WangBaren02/Image-acquisition-and-recognition-robotic-arm-analysis-and-control-system-based-on-FPGA/rtl/vision/color_space/reference/README.md

# 颜色空间参考实现

[`VIP_RGB888_YCbCr444.v`](VIP_RGB888_YCbCr444.v) 是新上传目录中的独立颜色空间参考模块。文件内保留 CrazyBingo Corporation 的版权、作者和授权说明。

当前图像端顶层使用的是 [`../rgb2ycbcr.v`](../rgb2ycbcr.v)，不是本目录的 `VIP_RGB888_YCbCr444`。本目录文件不应被描述为活动实现或个人原创代码。
