WangBaren02/Image-acquisition-and-recognition-robotic-arm-analysis-and-control-system-based-on-FPGA/docs/competition_presentation.pdf

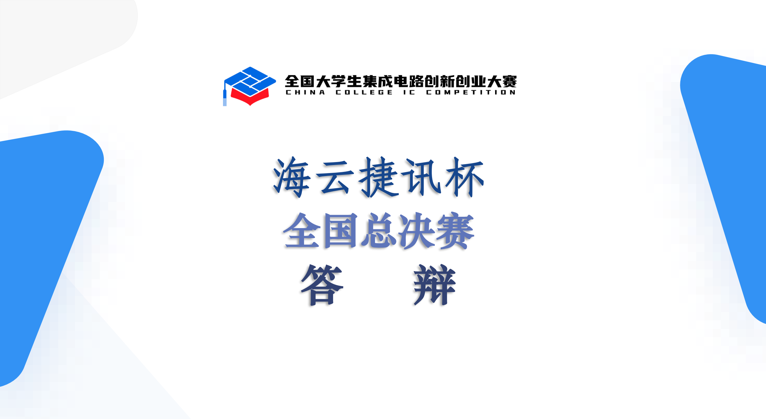
[picture p52: page 1]

# 海云捷讯杯

# 全国总决赛

答 辩

# 基于FPGA的图像识别和机械臂精准控制系统设计

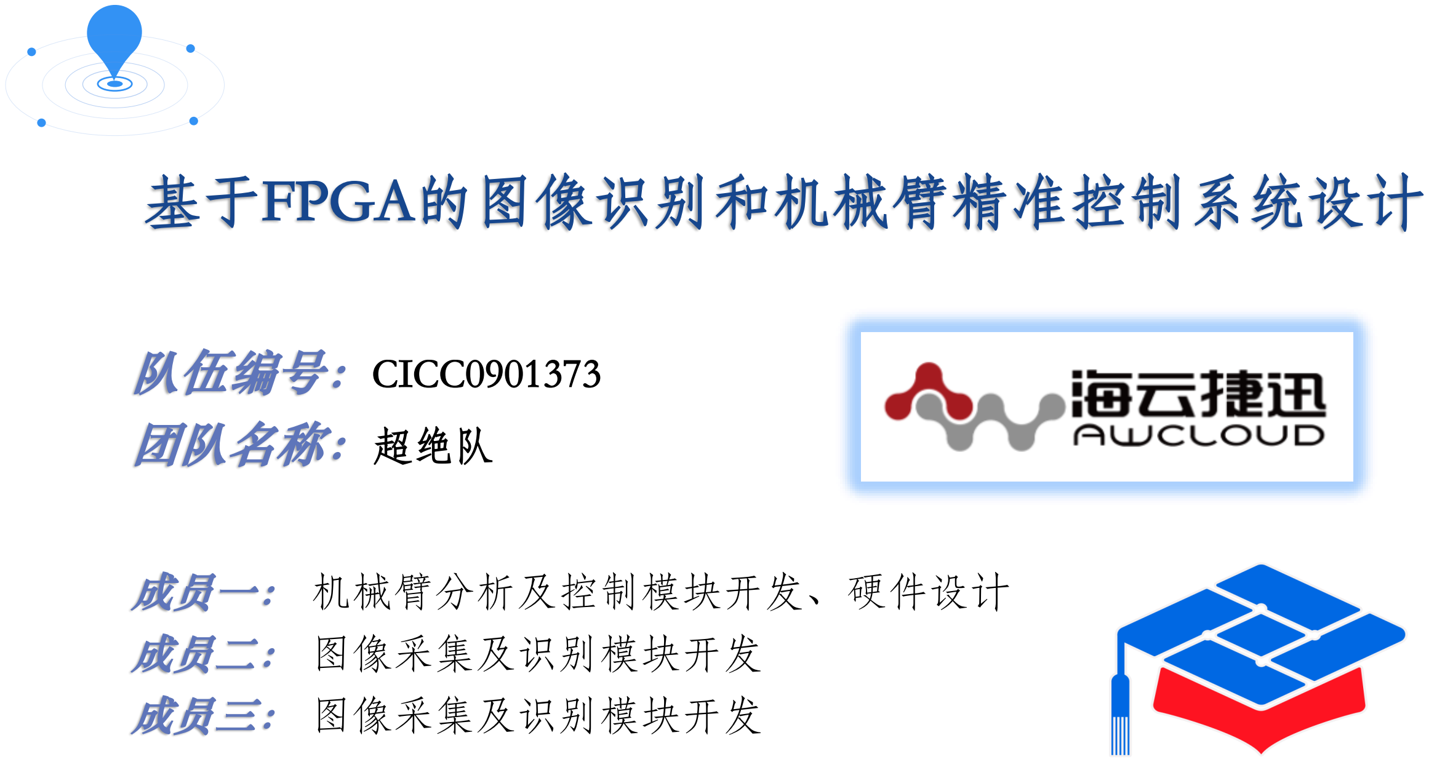
[picture p53: page 2]

## 队伍编号：CICC0901373

## 团队名称：超绝队

## 成员一： 机械臂分析及控制模块开发、硬件设计 成员二： 图像采集及识别模块开发 成员三： 图像采集及识别模块开发

目 录

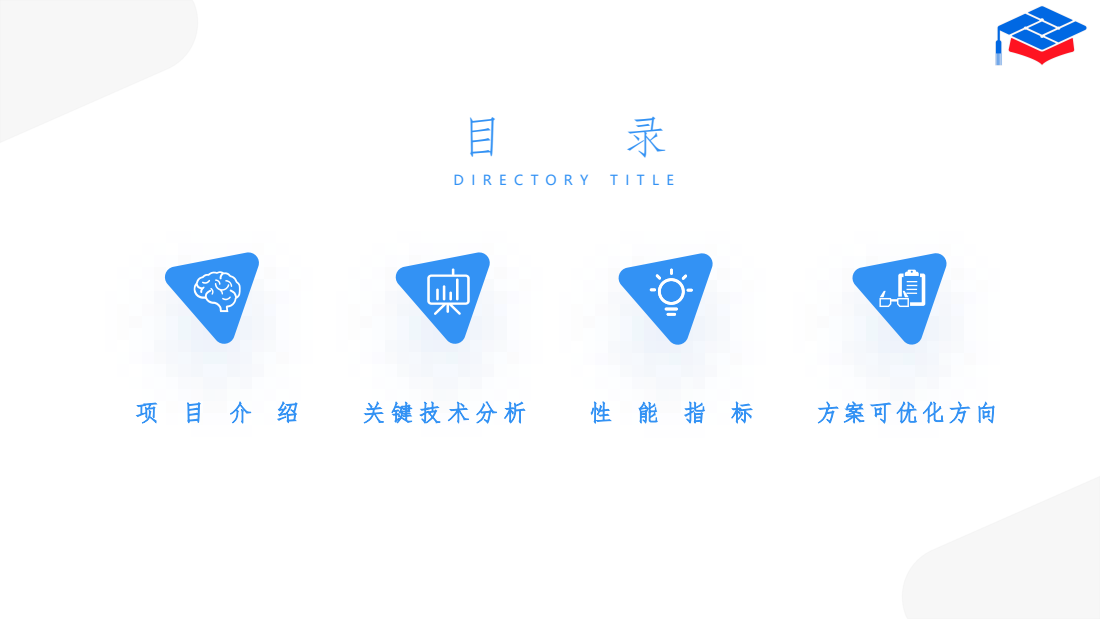
[picture p54: page 3]
项目介绍; 性能指标; 方案可优化方向

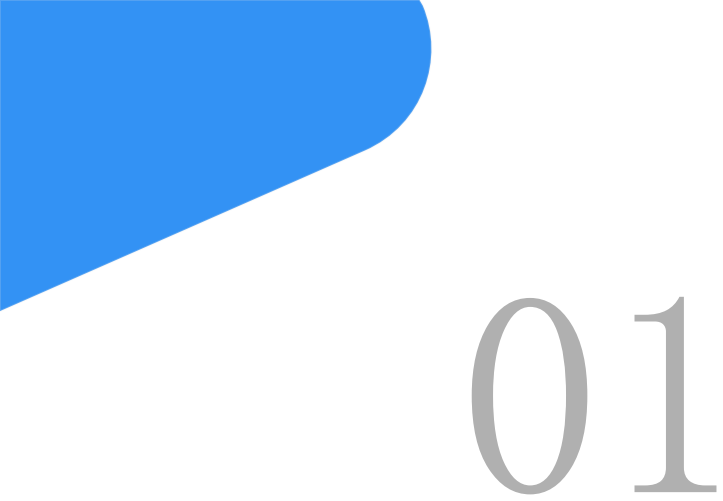
[picture p55: figure]

# 项目介绍

# 系统总体设计方案

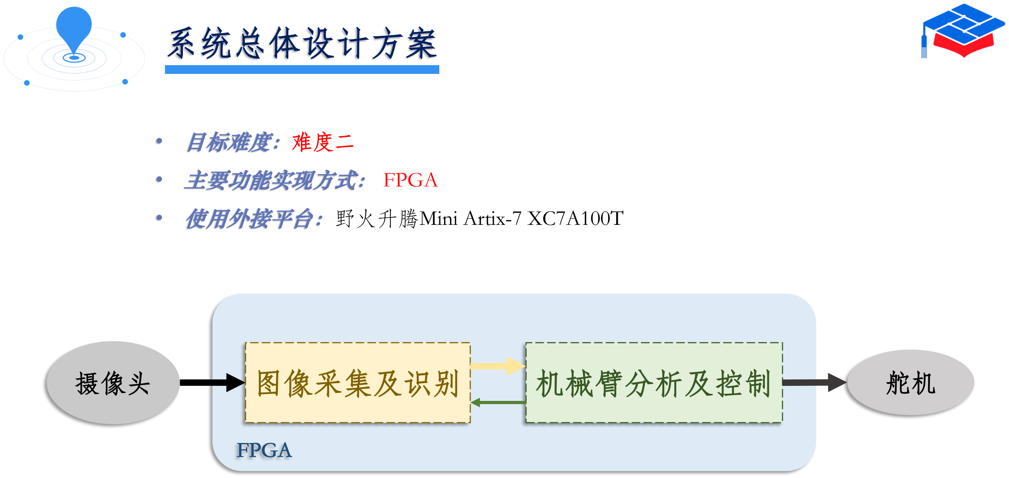
[picture p56: page 5]

- 目标难度：难度二
- 主要功能实现方式： FPGA
- 使用外接平台：野火升腾Mini Artix-7 XC7A100T
摄像头 | 图像采集及识别 | 机械臂分析及控制 | 舵机
| FPGA

## FPGA

# 总系统结构流程图

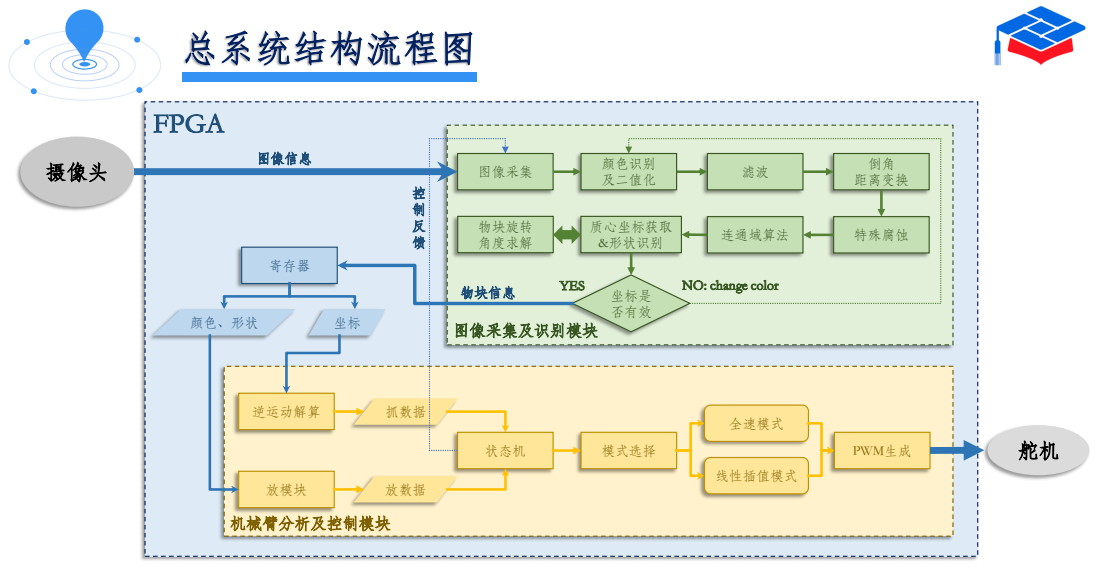
[picture p57: page 6]
逆运动解算; 抓数据; 全速模式; 放模块; 机械臂分析及控制模块; 放数据; 状态机; 模式选择; 线性插值模式; PWM生成; 图像采集; 颜色识别; 及二值化; 距离变换; 连通域算法; 特殊腐蚀 物块旋转; 角度求解; 寄存器; 图像采集及识别模块; 摄像头; 坐标是 否有效; 质心坐标获取 &形状识别; 图像信息; 物块信息; YES; NO: change color

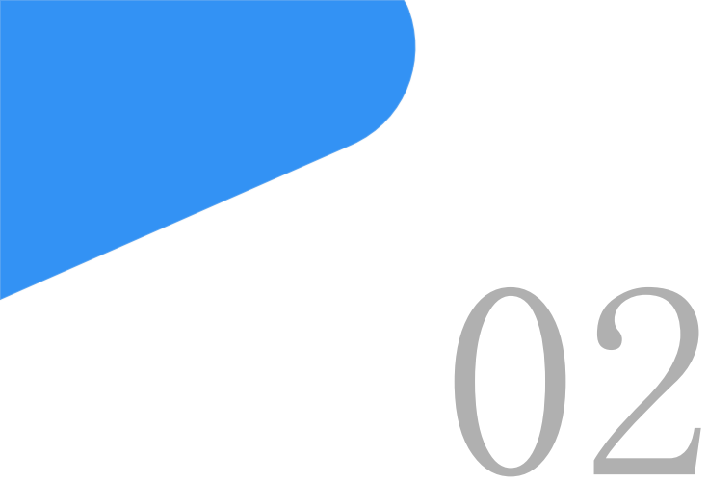
[picture p58: figure]
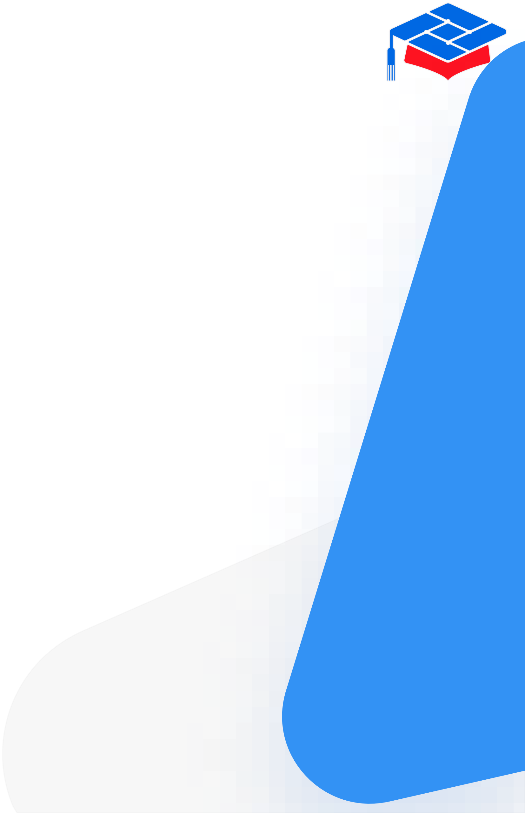
[picture p59: figure]

# 关键技术分析

# 图像采集及识别

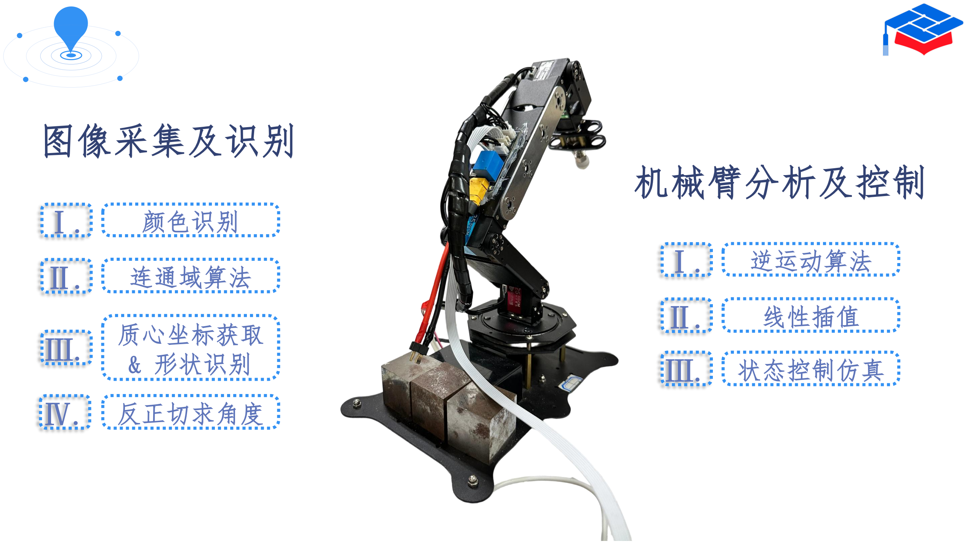
[picture p60: page 8]

## 连通域算法

## 颜色识别

Ⅱ.

Ⅰ.

# 机械臂分析及控制

## 质心坐标获取

Ⅲ & 形状识别 .

## 线性插值

## 逆运动算法

Ⅱ.

Ⅰ.

## Ⅲ. 状态控制仿真

Ⅳ

## . 反正切求角度

# 2.1 图像采集及识别模块流程

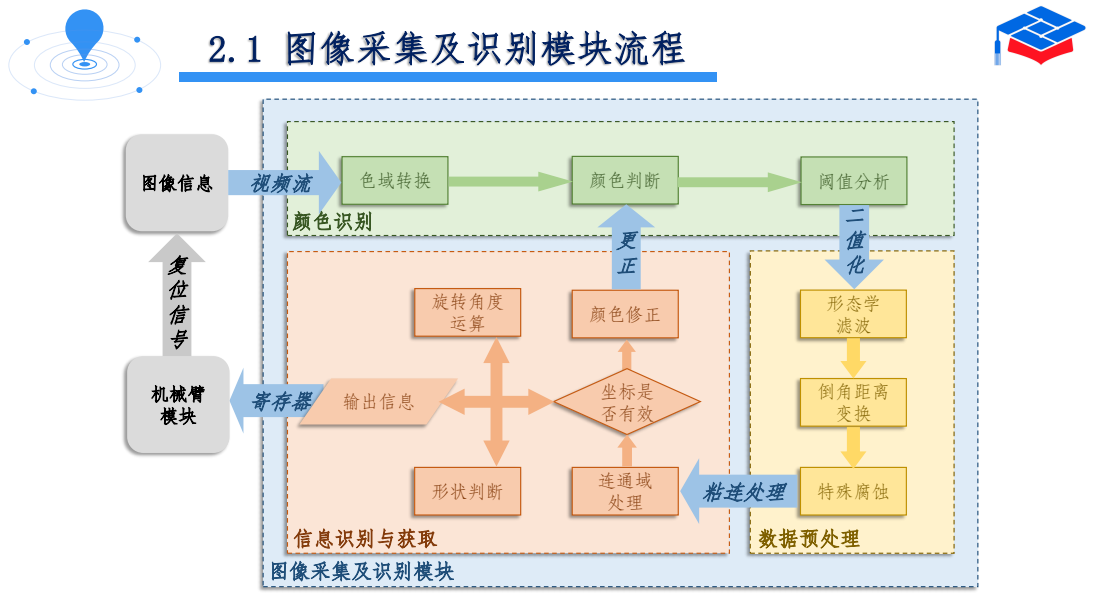
[picture p61: page 9]
图像信息; 色域转换; 颜色判断; 阈值分析; 形态学 滤波; 倒角距离 变换; 特殊腐蚀; 颜色修正; 连通域 处理; 坐标是 否有效; 旋转角度 运算; 形状判断; 机械臂; 寄存器; 输出信息 模块; 粘连处理; 视频流; 图像采集及识别模块; 颜色识别; 信息识别与获取; 数据预处理

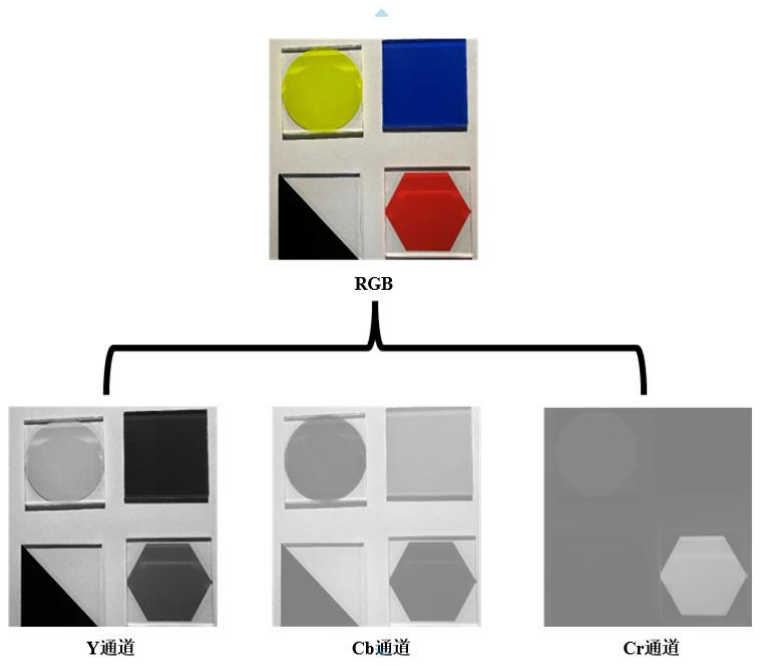
[picture p62: figure]

颜色 | 特征 | 控制阈值
红 | Y分量比黑色大且Cr分量最大 | Y、Cr

黄

Y分量在四种颜色里最大
且Cb分量最小 | Y、Cb

蓝

Y分量比黑色大、比红色小
且Cb分量最大 | Y、Cb
黑 | Y分量最小 | Y

采用两遍扫描法，在一帧图像的前一行打上标签，第二行进行上一行标签的更新。

给互不相连的物体打上不同的标签，以此达成分离物体的目的。

使用八连通域:指定像素的上下左右以及对角线方向上的8个像素为相邻像素。

在实现过程中对某一像素做具体判断的时候，只需要考虑头上三个以及左边的像素即可。

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
更新前标签 | 更新后标签

（a）

P

(x-1,y-1) | (x+1,y-1)

(x-1,y)
(b)

P

(x-1,y)

(x,y-1)

A.

B.

## 仿真结果（640 X 480）：

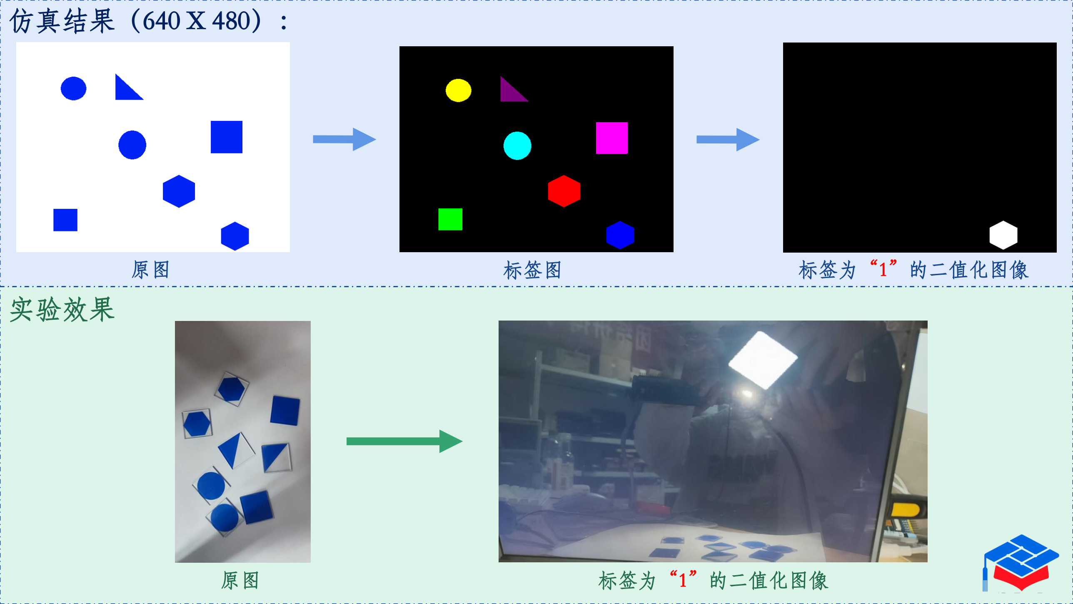
[picture p63: page 12]

原图 | 标签图 | 标签为“1”的二值化图像
原图 | 标签为“1”的二值化图像

## 实验效果

## A.加权平均值求质心

公式：

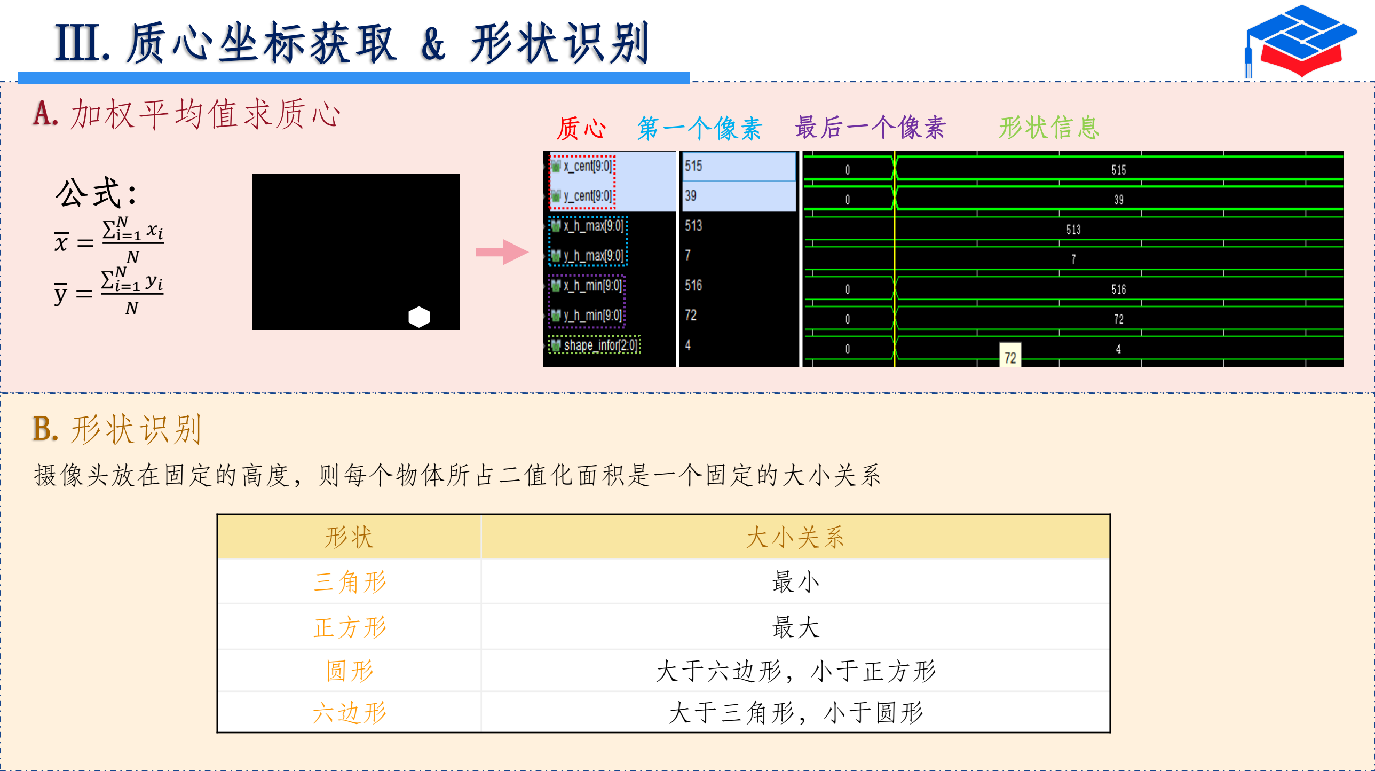
[picture p64: page 13]

形状 | 大小关系
三角形 | 最小
正方形 | 最大
圆形 | 大于六边形，小于正方形
六边形 | 大于三角形，小于圆形

x =

σi=1

N xi

N
y =

σi=1

N yi

N

# Ⅲ.质心坐标获取 & 形状识别

摄像头放在固定的高度，则每个物体所占二值化面积是一个固定的大小关系

## B.形状识别

质心 第一个像素 最后一个像素 形状信息

# Ⅳ.反正切求角度

圆形

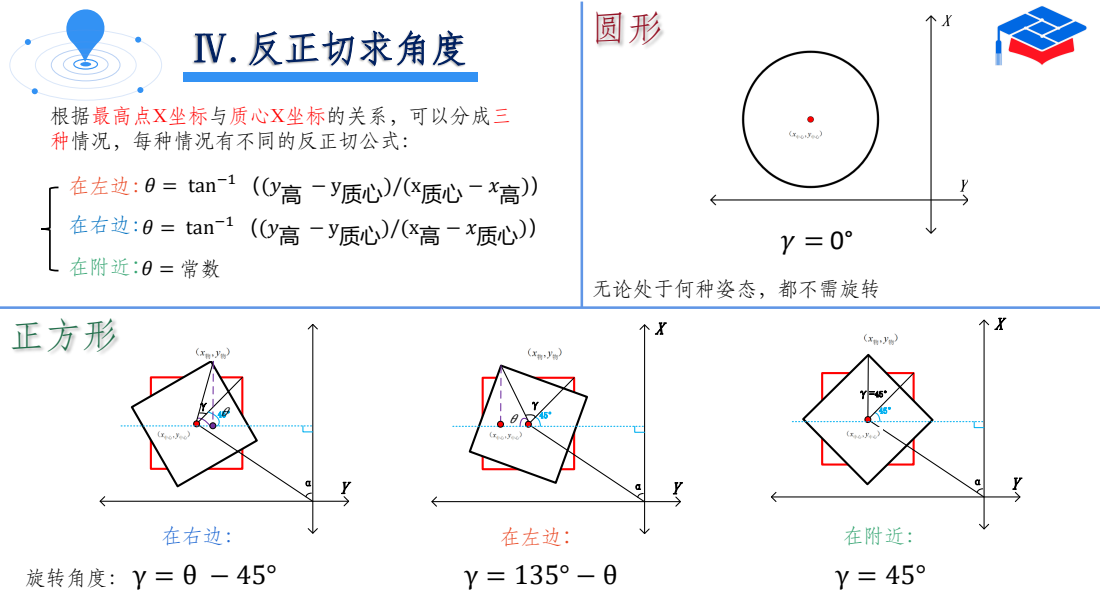
[picture p65: page 14]
根据最高点X坐标与质心X坐标的关系，可以分成三 种情况，每种情况有不同的反正切公式：; 在左边：; 在右边：; 在附近： θ = 常数; 无论处于何种姿态，都不需旋转; 正方形; 在附近：; 旋转角度： γ = θ − 45°

θ = tan⁻¹ （(y高 − y质心)/(x质心 − x高)）

θ = tan⁻¹ （(y高 − y质心)/(x高 − x质心)）

# 六边形 三角形

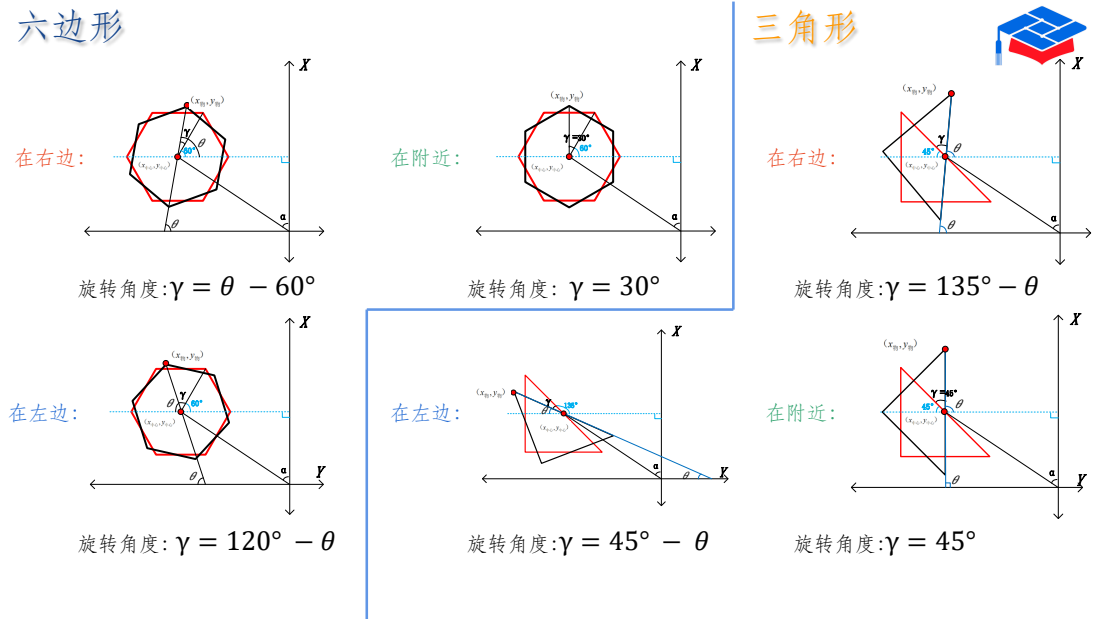
[picture p66: page 15]
旋转角度：γ = θ − 60°; 旋转角度：γ = 120° − θ; 在右边：; 在左边：; 在附近：; 旋转角度：γ = 30°; 旋转角度：γ = 135° − θ; 旋转角度：γ = 45° − θ; 旋转角度：γ = 45°

# 2.2 机械臂分析及控制模块流程

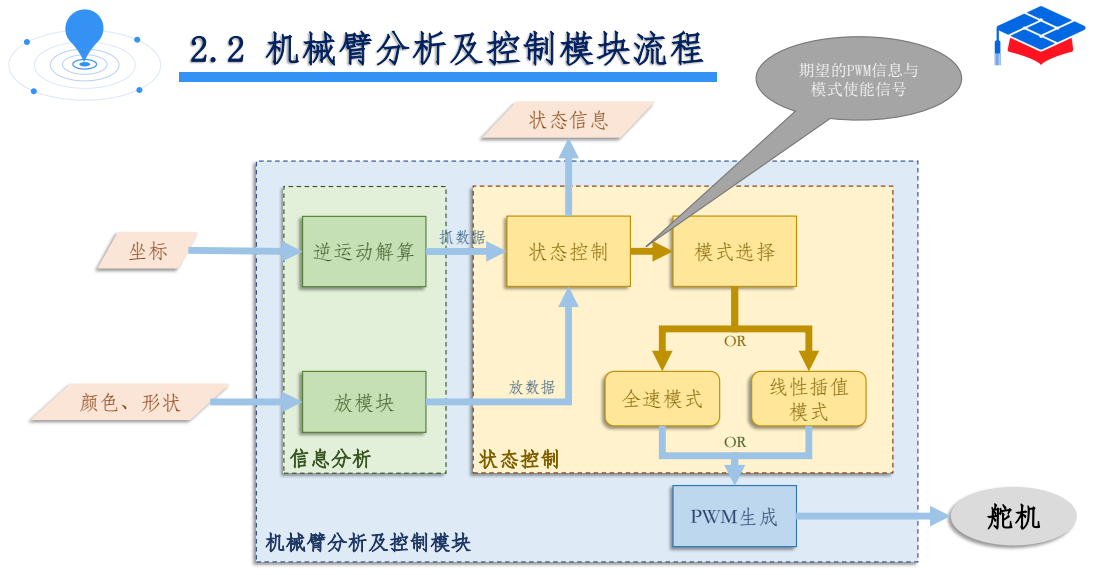
[picture p67: page 16]
逆运动解算; 模式选择; 全速模式; 线性插值 颜色、形状; 放模块; 状态控制; PWM生成; 信息分析; 期望的PWM信息与 模式使能信号; 抓数据; 放数据; 机械臂分析及控制模块; 状态信息

# Ⅰ.逆运动算法

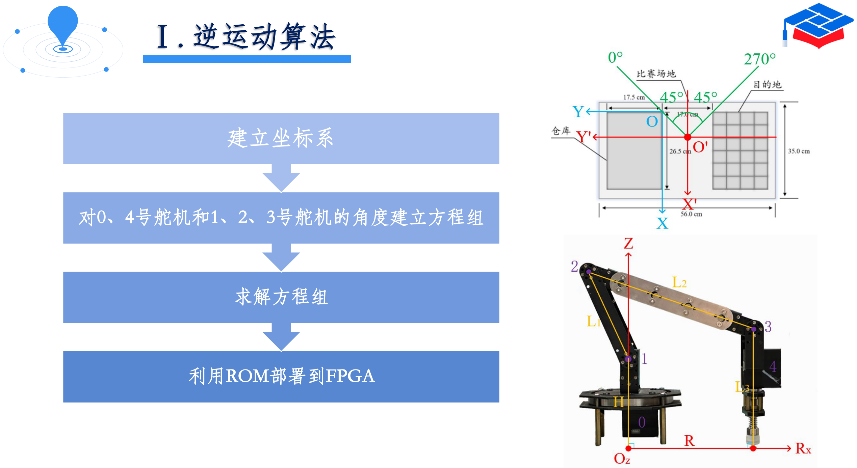
[picture p68: page 17]

利用ROM部署到FPGA

求解方程组

对0、4号舵机和1、2、3号舵机的角度建立方程组

## 建立坐标系

0、4号舵机角度的求解 | 1号、2号、3号舵机角度的求解

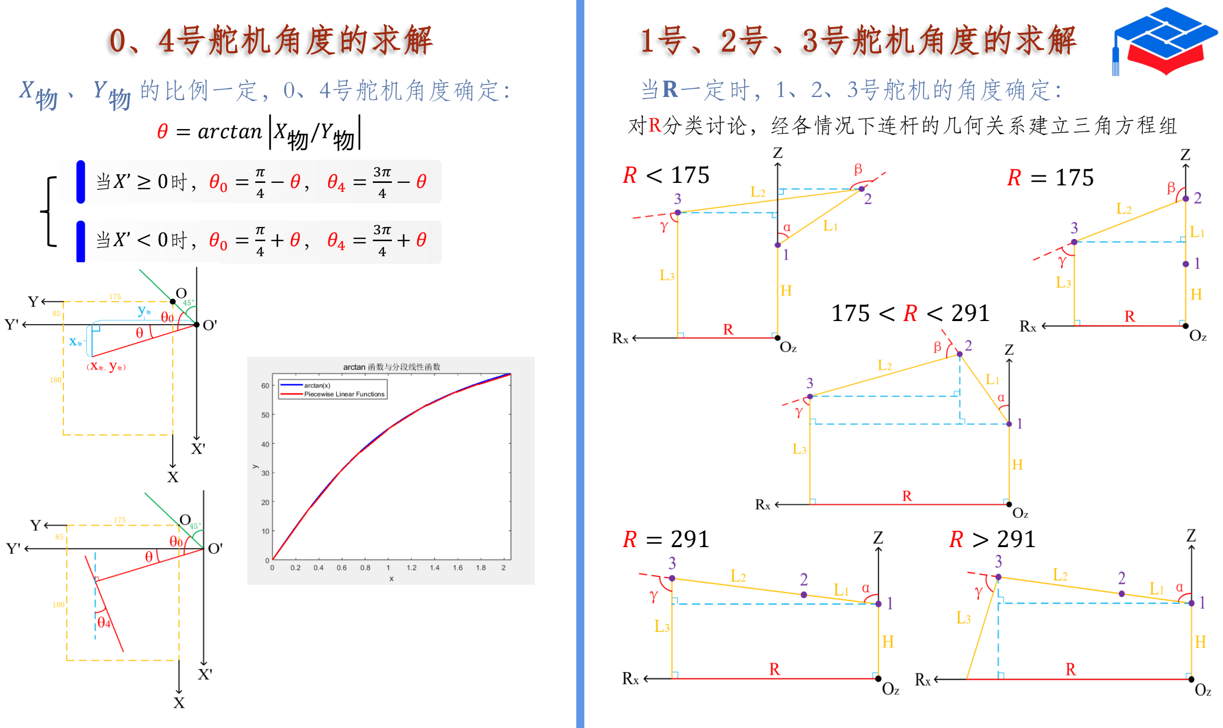
[picture p69: page 18]

当R一定时，1、2、3号舵机的角度确定：
对R分类讨论，经各情况下连杆的几何关系建立三角方程组

当X’ ≥ 0时，θ0 =

π
4

− θ， θ4 =

3π
4

− θ

X物 、 Y物 的比例一定，0、4号舵机角度确定：

θ = arctan X物/Y物

当X’ < 0时，θ0 =

π
4

+ θ， θ4 =

3π
4

+ θ

R < 175 | R = 175

175 < R < 291

R = 291 | R > 291

# Ⅱ.线性插值

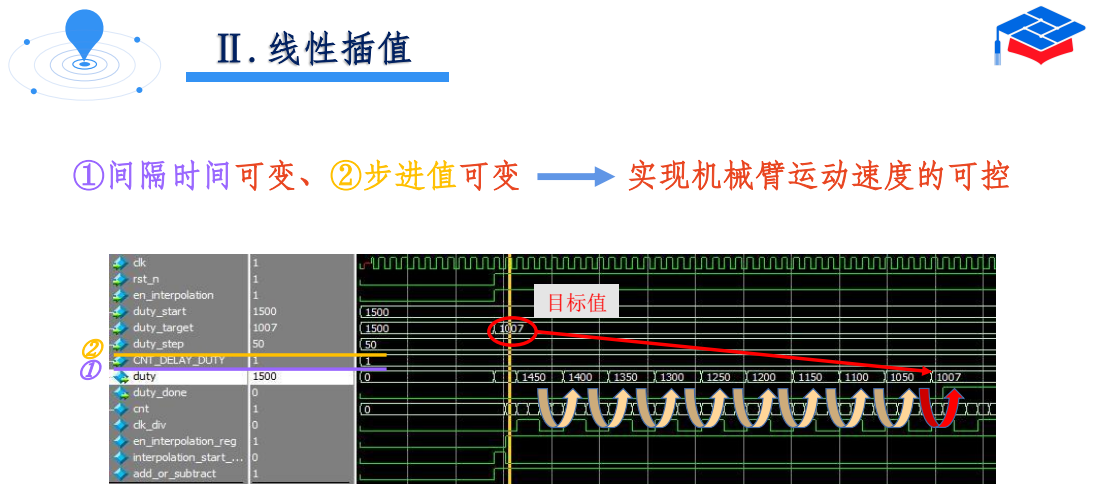
[picture p70: page 19]
①间隔时间可变、②步进值可变; 实现机械臂运动速度的可控; 目标值

抓姿态 | 复位姿态 | 放姿态

# Ⅲ.状态控制

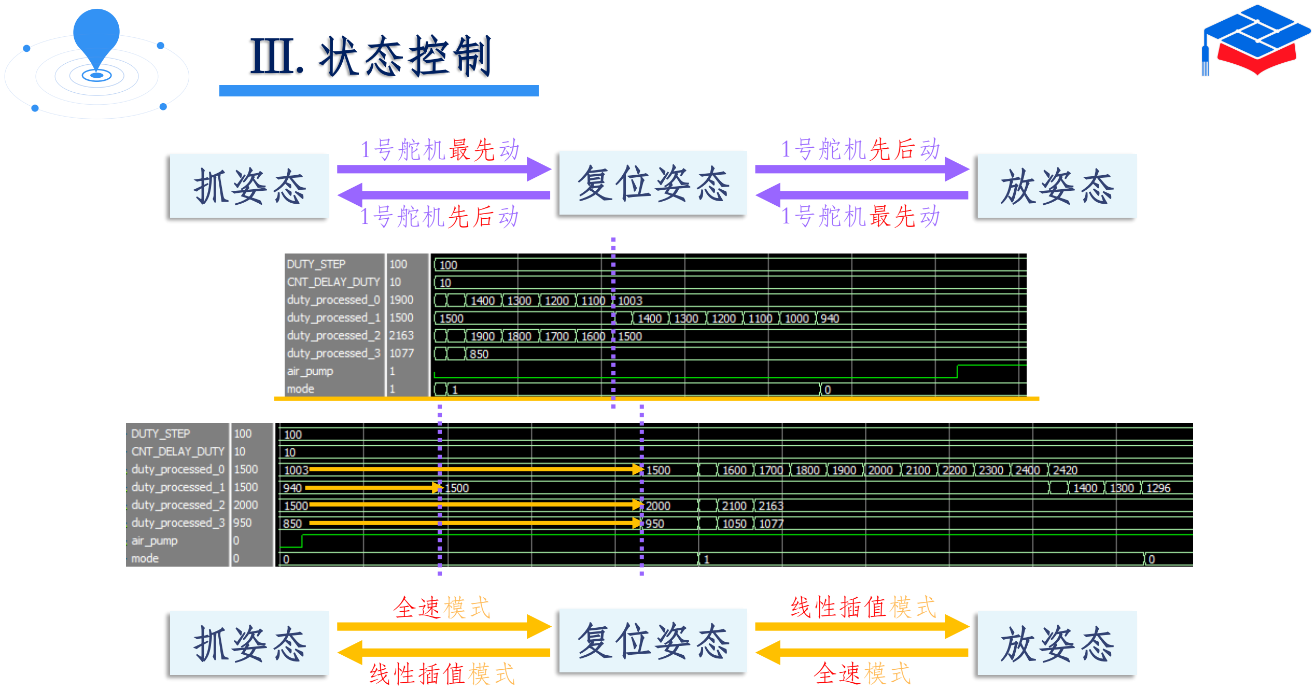
[picture p71: page 20]

1号舵机最先动

1号舵机先后动 | 1号舵机最先动 1号舵机先后动
抓姿态 | 复位姿态 | 放姿态

全速模式

线性插值模式 | 全速模式

线性插值模式

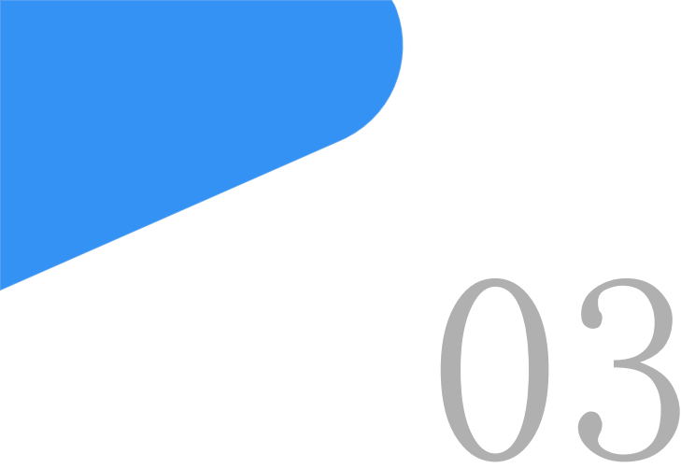
[picture p72: figure]

# 性能分析

测试序号 | 总时间(s) | 均方根误差(cm) | 方差(cm2
) | 均值误差(cm)
① | 6.94N | 1.45 | 2.27 | 1.30
② | 5.27N | 2.11 | 4.77 | 1.92
③ | 12.96N | 0.35 | 0.13 | 0.27

# 测试表

指标 | 此系统
目标锁定时间(s) | 0.067N
完成任务总时间(s) | 6.94N
定位精度 | 一般

# 性能指标

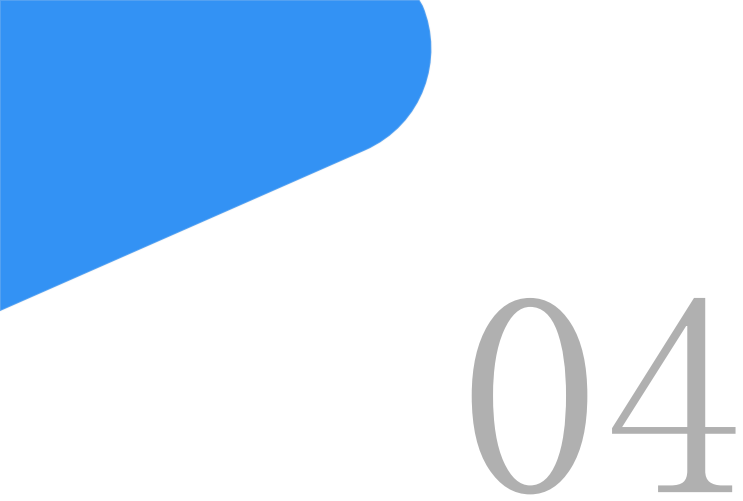
[picture p73: figure]
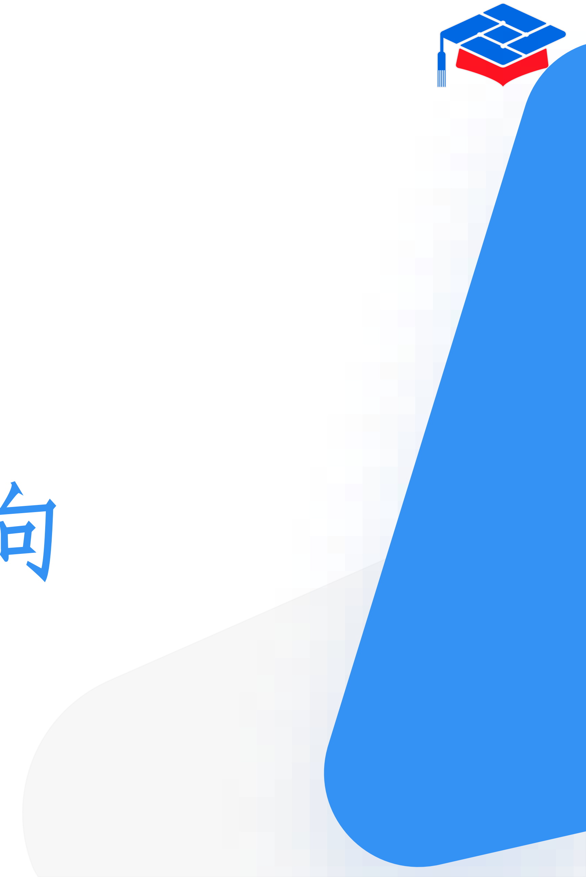
[picture p74: figure]

# 方案可优化方向

1
1
2 | 2 | 1 | 1

1
1
1 | 1 | 1 | 1

解决方案:在处理当前行标签的时候，增加“回溯”功能即增加固定次数的循环结构，把当前所要 给的标签赋值给被循环的像素。

解决方案:在连通域模块之前添加滤波/腐蚀，保证模块传入的数据没有噪点。

出现问题:在本系统现阶段的连通域算法中，所处理图像的边缘由于二值化阈值范围与光照环 境影响下，可能会出现“左L”形的情景：

A.

出现问题:由于连通域算法将标签为1的物体输出，而且求取质心的公式与像素的xy坐标有关系。 所以图像识别模块容易收到噪点以及外部环境的影响

B.

更新前标签 | 更新后标签

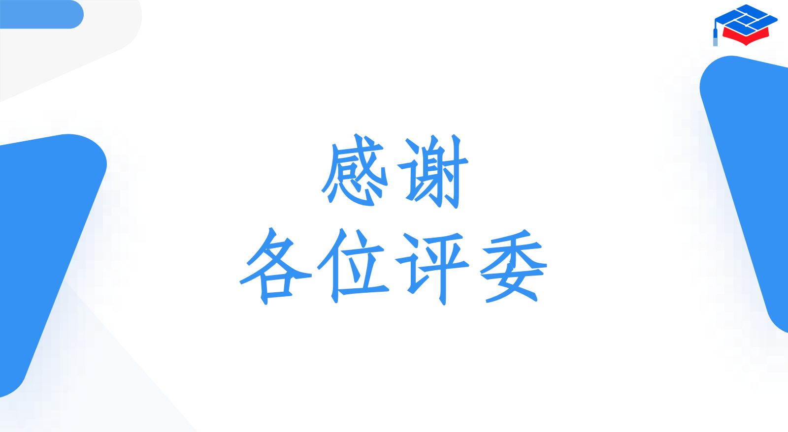
[picture p75: page 25]

感谢

# 各位评委
