WangBaren02/Image-acquisition-and-recognition-robotic-arm-analysis-and-control-system-based-on-FPGA/(list of files, drawings)

Other design files:
hardware/25集创赛海云捷讯杯.epro
