WangBaren02/Image-acquisition-and-recognition-robotic-arm-analysis-and-control-system-based-on-FPGA/rtl/display/seven_segment/bcd_8421.v

`timescale  1ns/1ns
////////////////////////////////////////////////////////////////////////
// Author  : EmbedFire
// 实验平台: 野火FPGA系列开发板
// 公司    : http://www.embedfire.com
// 论坛    : http://www.firebbs.cn
// 淘宝    : https://fire-stm32.taobao.com
////////////////////////////////////////////////////////////////////////

module  bcd_8421
(
    input   wire            sys_clk     ,   //系统时钟，频率50MHz
    input   wire            sys_rst_n   ,   //复位信号，低电平有效
    input   wire    [19:0]  data        ,   //输入需要转换的数据

    output  reg     [3:0]   unit        ,   //个位BCD码
    output  reg     [3:0]   ten         ,   //十位BCD码
    output  reg     [3:0]   hun         ,   //百位BCD码
    output  reg     [3:0]   tho         ,   //千位BCD码
    output  reg     [3:0]   t_tho       ,   //万位BCD码
    output  reg     [3:0]   h_hun           //十万位BCD码
);

//********************************************************************//
//******************** Parameter And Internal Signal *****************//
//********************************************************************//

//reg   define
reg     [4:0]   cnt_shift   ;   //移位判断计数器
reg     [43:0]  data_shift  ;   //移位判断数据寄存器
reg             shift_flag  ;   //移位判断标志信号

//********************************************************************//
//***************************** Main Code ****************************//
//********************************************************************//

//cnt_shift:从0到21循环计数
always@(posedge sys_clk or negedge sys_rst_n)
    if(sys_rst_n == 1'b0)
        cnt_shift   <=  5'd0;
    else    if((cnt_shift == 5'd21) && (shift_flag == 1'b1))
        cnt_shift   <=  5'd0;
    else    if(shift_flag == 1'b1)
        cnt_shift   <=  cnt_shift + 1'b1;
    else
        cnt_shift   <=  cnt_shift;

//data_shift：计数器为0时赋初值，计数器为1~20时进行移位判断操作
always@(posedge sys_clk or negedge sys_rst_n)
    if(sys_rst_n == 1'b0)
        data_shift  <=  44'b0;
    else    if(cnt_shift == 5'd0)
        data_shift  <=  {24'b0,data};
    else    if((cnt_shift <= 20) && (shift_flag == 1'b0))
        begin
            data_shift[23:20]   <=  (data_shift[23:20] > 4) ? (data_shift[23:20] + 2'd3) : (data_shift[23:20]);
            data_shift[27:24]   <=  (data_shift[27:24] > 4) ? (data_shift[27:24] + 2'd3) : (data_shift[27:24]);
            data_shift[31:28]   <=  (data_shift[31:28] > 4) ? (data_shift[31:28] + 2'd3) : (data_shift[31:28]);
            data_shift[35:32]   <=  (data_shift[35:32] > 4) ? (data_shift[35:32] + 2'd3) : (data_shift[35:32]);
            data_shift[39:36]   <=  (data_shift[39:36] > 4) ? (data_shift[39:36] + 2'd3) : (data_shift[39:36]);
            data_shift[43:40]   <=  (data_shift[43:40] > 4) ? (data_shift[43:40] + 2'd3) : (data_shift[43:40]);
        end
    else    if((cnt_shift <= 20) && (shift_flag == 1'b1))
        data_shift  <=  data_shift << 1;
    else
        data_shift  <=  data_shift;

//shift_flag：移位判断标志信号，用于控制移位判断的先后顺序
always@(posedge sys_clk or negedge sys_rst_n)
    if(sys_rst_n == 1'b0)
        shift_flag  <=  1'b0;
    else
        shift_flag  <=  ~shift_flag;

//当计数器等于20时，移位判断操作完成，对各个位数的BCD码进行赋值
always@(posedge sys_clk or negedge sys_rst_n)
    if(sys_rst_n == 1'b0)
        begin
            unit    <=  4'b0;
            ten     <=  4'b0;
            hun     <=  4'b0;
            tho     <=  4'b0;
            t_tho   <=  4'b0;
            h_hun   <=  4'b0;
        end
    else    if(cnt_shift == 5'd21)
        begin
            unit    <=  data_shift[23:20];
            ten     <=  data_shift[27:24];
            hun     <=  data_shift[31:28];
            tho     <=  data_shift[35:32];
            t_tho   <=  data_shift[39:36];
            h_hun   <=  data_shift[43:40];
        end

endmodule
