WangBaren02/Image-acquisition-and-recognition-robotic-arm-analysis-and-control-system-based-on-FPGA/sim/vision/sim_sobel_tb.v

`timescale 1ns / 1ps

//使用BMP图片格式仿真VIP视频图像处理算法
module sim_sobel_tb( );

integer iBmpFileId;                 //输入BMP图片
integer oBmpFileId_1;               //输出BMP图片 1

integer iIndex = 0;                 //输出BMP数据索引
integer pixel_index = 0;            //输出像素数据索引

integer iCode;

integer iBmpWidth;                  //输入BMP 宽度
integer iBmpHight;                  //输入BMP 高度
integer iBmpSize;                   //输入BMP 字节数
integer iDataStartIndex;            //输入BMP 像素数据偏移量

reg [7:0] rBmpData [0:2000000];      //用于寄存输入BMP图片中的字节数据（包括54字节的文件头）
reg [7:0] Vip_BmpData_1 [0:2000000]; //用于寄存视频图像处理之后 的BMP图片 数据

reg [7:0] rBmpWord;                //输出BMP图片时用于寄存数据（以byte为单位）

reg [ 7:0] pixel_data;              //输出视频流时的像素数据

reg clk;
reg rst_n;

reg [ 7:0] vip_pixel_data_1 [0:921600];   	//640x480x3

//---------------------------------------------
initial begin
    //打开输入BMP图片s
	 iBmpFileId      = $fopen("F:\\FPGA-EP4CE10F17C8\\change\\sim\\bmp_tb_640x480\\bmp_pic_100_4l_1.bmp","rb");

    //将输入BMP图片加载到数组中
	iCode = $fread(rBmpData,iBmpFileId);

    //根据BMP图片文件头的格式，分别计算出图片的 宽度 /高度 /像素数据偏移量 /图片字节数
	iBmpWidth       = {rBmpData[21],rBmpData[20],rBmpData[19],rBmpData[18]};
	iBmpHight       = {rBmpData[25],rBmpData[24],rBmpData[23],rBmpData[22]};
	iBmpSize        = {rBmpData[ 5],rBmpData[ 4],rBmpData[ 3],rBmpData[ 2]};
	iDataStartIndex = {rBmpData[13],rBmpData[12],rBmpData[11],rBmpData[10]};

    //关闭输入BMP图片
	$fclose(iBmpFileId);

	//打开输出BMP图片
	oBmpFileId_1 = $fopen("F:\\FPGA-EP4CE10F17C8\\change\\sim\\bmp_tb_640x480\\output_file_1.bmp","wb+");

    //延迟13ms，等待第一帧VIP处理结束
    #13000000

    //加载图像处理后，BMP图片的文件头和像素数据
	for (iIndex = 0; iIndex < iBmpSize; iIndex = iIndex + 1) begin
		if(iIndex < 54)
            Vip_BmpData_1[iIndex] = rBmpData[iIndex];
        else
            Vip_BmpData_1[iIndex] = vip_pixel_data_1[iIndex-54];
	end
    //将数组中的数据写到输出BMP图片中
	for (iIndex = 0; iIndex < iBmpSize; iIndex = iIndex + 1) begin
		rBmpWord = Vip_BmpData_1[iIndex];
		$fwrite(oBmpFileId_1,"%c",rBmpWord);
	end

    //关闭输出BMP图片
	$fclose(oBmpFileId_1);

end
//initial end

//---------------------------------------------
//初始化时钟和复位信号
initial begin
    clk     = 1;
    rst_n   = 0;
    #110
    rst_n   = 1;
end

//产生50MHz时钟
always #10 clk = ~clk;

//---------------------------------------------
//在时钟驱动下，从数组中读出像素数据，用于在Modelsim中查看BMP中的数据
always@(posedge clk or negedge rst_n)begin
    if(!rst_n) begin
        pixel_data  <=  8'd0;
        pixel_index <=  0;
    end
    else begin
        pixel_data  <=  rBmpData[pixel_index];
        pixel_index <=  pixel_index+1;
    end
end

//---------------------------------------------
//产生摄像头时序

wire		cmos_vsync ;
reg			cmos_href;
wire        cmos_clken;
reg	[23:0]	cmos_data;

reg         cmos_clken_r;

reg [31:0]  cmos_index;

parameter [10:0] IMG_HDISP = 11'd640;
parameter [10:0] IMG_VDISP = 11'd480;

localparam H_SYNC = 11'd5;
localparam H_BACK = 11'd5;
localparam H_DISP = IMG_HDISP;
localparam H_FRONT = 11'd5;
localparam H_TOTAL = H_SYNC + H_BACK + H_DISP + H_FRONT;

localparam V_SYNC = 11'd1;
localparam V_BACK = 11'd0;
localparam V_DISP = IMG_VDISP;
localparam V_FRONT = 11'd1;
localparam V_TOTAL = V_SYNC + V_BACK + V_DISP + V_FRONT;

//---------------------------------------------
//模拟 OV7725/OV5640 驱动模块输出的时钟使能
always@(posedge clk or negedge rst_n) begin
	if(!rst_n)
		cmos_clken_r <= 0;
	else
        cmos_clken_r <= ~cmos_clken_r;
end

//---------------------------------------------
//水平计数器
reg	[10:0]	hcnt;
always@(posedge clk or negedge rst_n) begin
	if(!rst_n)
		hcnt <= 11'd0;
	else if(cmos_clken_r)
		hcnt <= (hcnt < H_TOTAL - 1'b1) ? hcnt + 1'b1 : 11'd0;
end

//---------------------------------------------
//竖直计数器
reg	[10:0]	vcnt;
always@(posedge clk or negedge rst_n) begin
	if(!rst_n)
		vcnt <= 11'd0;
	else if(cmos_clken_r) begin
		if(hcnt == H_TOTAL - 1'b1)
			vcnt <= (vcnt < V_TOTAL - 1'b1) ? vcnt + 1'b1 : 11'd0;
		else
			vcnt <= vcnt;
    end
end

//---------------------------------------------
//场同步
reg	cmos_vsync_r;
always@(posedge clk or negedge rst_n) begin
	if(!rst_n)
		cmos_vsync_r <= 1'b0;			//H: Vaild, L: inVaild
	else begin
		if(vcnt <= V_SYNC - 1'b1)
			cmos_vsync_r <= 1'b0; 	//H: Vaild, L: inVaild
		else
			cmos_vsync_r <= 1'b1; 	//H: Vaild, L: inVaild
    end
end
assign	cmos_vsync	= cmos_vsync_r;

//---------------------------------------------
//行有效
wire	frame_valid_ahead =  ( vcnt >= V_SYNC + V_BACK  && vcnt < V_SYNC + V_BACK + V_DISP
                            && hcnt >= H_SYNC + H_BACK  && hcnt < H_SYNC + H_BACK + H_DISP )
						? 1'b1 : 1'b0;

reg			cmos_href_r;
always@(posedge clk or negedge rst_n) begin
	if(!rst_n)
		cmos_href_r <= 0;
	else begin
		if(frame_valid_ahead)
			cmos_href_r <= 1;
		else
			cmos_href_r <= 0;
    end
end

always@(posedge clk or negedge rst_n) begin
	if(!rst_n)
		cmos_href <= 0;
	else
        cmos_href <= cmos_href_r;
end

assign cmos_clken = cmos_href & cmos_clken_r;

//-------------------------------------
//从数组中以视频格式输出像素数据
wire [10:0] x_pos;
wire [10:0] y_pos;

assign x_pos = frame_valid_ahead ? (hcnt - (H_SYNC + H_BACK )) : 0;
assign y_pos = frame_valid_ahead ? (vcnt - (V_SYNC + V_BACK )) : 0;

always@(posedge clk or negedge rst_n)begin
   if(!rst_n) begin
       cmos_index   <=  0;
       cmos_data    <=  24'd0;
   end
   else begin
       //cmos_index   <=  y_pos * 960  + x_pos*3 + 54;        //  3*(y*320 + x) + 54
       cmos_index   <=  y_pos * 1920  + x_pos*3 + 54;         //  3*(y*640 + x) + 54
       cmos_data    <=  {rBmpData[cmos_index], rBmpData[cmos_index+1] , rBmpData[cmos_index+2]};
   end
end

//-------------------------------------
//VIP算法--彩色转灰度

wire 		per_frame_vsync	=	cmos_vsync ;
wire 		per_frame_href	=	cmos_href;
wire 		per_frame_clken	=	cmos_clken;
wire [7:0]	per_img_red		=	cmos_data[ 7: 0];
wire [7:0]	per_img_green	=	cmos_data[15: 8];
wire [7:0]	per_img_blue	=	cmos_data[23:16];


wire 		post0_frame_vsync;
wire 		post0_frame_href ;
wire 		post0_frame_clken;
wire [7:0]	post0_img_Y      ;
wire [7:0]	post0_img_Cb     ;
wire [7:0]	post0_img_Cr     ;

wire		vsync_out	;
wire		href_out	;
wire		de_out		;
wire		bin_out     ;
//wire	[23:0]	rgb_out	;
VIP_RGB888_YCbCr444	u_VIP_RGB888_YCbCr444
(
	//global clock
	.clk				(clk),
	.rst_n				(rst_n),

	//Image data prepred to be processd
	.per_frame_vsync	(per_frame_vsync),
	.per_frame_href		(per_frame_href),
	.per_frame_clken	(per_frame_clken),
	.per_img_red		(per_img_red),
	.per_img_green		(per_img_green),
	.per_img_blue		(per_img_blue),

	//Image data has been processd
	.post_frame_vsync	(post0_frame_vsync),
	.post_frame_href	(post0_frame_href),
	.post_frame_clken	(post0_frame_clken),
	.post_img_Y			(post0_img_Y ),
	.post_img_Cb		(post0_img_Cb),
	.post_img_Cr		(post0_img_Cr)
);

//--------------------------------------
//VIP算法--二值化

wire			post1_frame_vsync;
wire			post1_frame_href ;
wire			post1_frame_clken;
wire	     	post1_img_Bit    ;

//binarization u_binarization (
//	.clk					(clk),
//	.rst_n					(rst_n),
//
//	//Image data prepred to be processd
//	.per_frame_vsync		(post0_frame_vsync),
//	.per_frame_href			(post0_frame_href),
//	.per_frame_clken		(post0_frame_clken),
//	.per_img_Y				(post0_img_Y),
//
//	//Image data has been processd
//	.post_frame_vsync		(post1_frame_vsync),
//	.post_frame_href		(post1_frame_href),
//	.post_frame_clken		(post1_frame_clken),
//	.post_img_Bit			(post1_img_Bit),
//
//	//二值化阈值
//	.Binary_Threshold		(150)
//);

//connect_component_top	connect_component_top_inst//用于仿真版顶层代码
//(
//	.clk				(clk),
//	.rst_n				(rst_n),
//	.per_frame_vsync	(post0_frame_vsync),
//	.per_frame_href		(post0_frame_href),
//	.per_frame_clken	(post0_frame_clken),
//	.per_img_Y			(post0_img_Y),
//	.per_img_Cb			(post0_img_Cb),
//	.per_img_Cr			(post0_img_Cr),
//   	.vsync_out			(vsync_out),
//	.href_out			(href_out),
//	.de_out				(de_out),
//
//	.bin_out            (bin_out)
//);
//connect_component_top	connect_component_top_inst//用于仿真版顶层代码
//(
//	.clk				(clk),
//	.rst_n				(rst_n),
//	.per_frame_vsync	(post0_frame_vsync),
//	.per_frame_href		(post0_frame_href),
//	.per_frame_clken	(post0_frame_clken),
//	.per_img_Y			(post0_img_Y),
//	.per_img_Cb			(post0_img_Cb),
//	.per_img_Cr			(post0_img_Cr),
//
//	.vsync_out			(vsync_out),
//	.href_out			(href_out),
//	.de_out				(de_out),
//	.bin_out	        (bin_out)
//	//output	wire		rgb_out	bin_out
//);

wire			key_color		;
wire			key_mode		;
wire            key_ycbcr	    ;
wire            key_add_div     ;
wire            change_in        ;



wire	[1:0]	color			;
wire	[1:0]	shape_infor		;


wire			ram_wr_en		;
wire	[28:0]	ram_wr_data		;
wire	[2:0]	ycbcr_led		;
wire			mode_led		;
wire	[19:0]	seg_data		;

assign	key_color = 1'b0;
assign	key_mode  = 1'b0;
assign	key_ycbcr = 1'b0;
assign	key_add_div = 1'b0;
assign	change_in = 1'b0;




//connect_component_top	connect_component_top_INST//用于仿真版顶层代砿
//(
//	.clk				(clk				),
//	.rst_n				(rst_n				),
//	.per_frame_vsync	(per_frame_vsync	),
//	.per_frame_href		(per_frame_href		),
//	.per_frame_clken	(per_frame_clken	),
//	.per_img_Y			(post0_img_Y			),
//	.per_img_Cb			(per_img_Cb			),
//	.per_img_Cr			(per_img_Cr			),
//	.key_color			(key_color			),
//
//	.color				(color			),
//	.shape_infor		(shape_infor	),
//
//	.ram_wr_en			(ram_wr_en	),
//	.ram_wr_data		(ram_wr_data),
//	.vsync_out			(vsync_out	),
//	.href_out			(href_out	),
//	.de_out				(de_out		),
//	.bin_out			(bin_out	)
//
//);
connect_component_top	connect_component_top_inst//用于仿真版顶层代砿
(
	.clk				(clk				),
	.rst_n				(rst_n				),
	.per_frame_vsync	(per_frame_vsync	),
	.per_frame_href		(per_frame_href		),
	.per_frame_clken	(per_frame_clken	),
	.per_img_Y			(post0_img_Y			),
	.per_img_Cb			(post0_img_Cb			),
	.per_img_Cr			(post0_img_Cr			),
	.change_in			(change_in			),
	.key_color			(key_color	),
	.key_mode			(key_mode),
	.key_ycbcr			(key_ycbcr),
	.key_add_div		(key_add_div),

	.ycbcr_led			(ycbcr_led	),
	.mode_led			(mode_led	),
	.seg_data			(seg_data	),
	.color				(color		),
	.shape_infor		(shape_infor),

	.ram_wr_en			(ram_wr_en	),
	.ram_wr_data		(ram_wr_data),
	.vsync_out			(vsync_out	),
	.href_out			(href_out	),
	.de_out				(de_out		),
	.bin_out			(bin_out	)

);









////--------------------------------------
////VIP算法--腐蚀
//wire			post2_frame_vsync;
//wire			post2_frame_href;
//wire			post2_frame_clken;
//wire			post2_img_Bit;
//
//VIP_Bit_Erosion_Detector
//#(
//	.IMG_HDISP	(IMG_HDISP),	//640*480
//	.IMG_VDISP	(IMG_VDISP)
//)
//u_VIP_Bit_Erosion_Detector
//(
//	//global clock
//	.clk					(clk),
//	.rst_n					(rst_n),
//
//	//Image data prepred to be processd
//	.per_frame_vsync		(post1_frame_vsync),
//	.per_frame_href			(post1_frame_href),
//	.per_frame_clken		(post1_frame_clken),
//	.per_img_Bit			(post1_img_Bit),
//
//	//Image data has been processd
//	.post_frame_vsync		(post2_frame_vsync),
//	.post_frame_href		(post2_frame_href),
//	.post_frame_clken		(post2_frame_clken),
//	.post_img_Bit			(post2_img_Bit)
//);
//
//
////--------------------------------------
////VIP 算法--Sobel边缘检测
//
//wire			post4_frame_vsync;
//wire			post4_frame_href;
//wire			post4_frame_clken;
//wire			post4_img_Bit;
//
//VIP_Sobel_Edge_Detector #(
//	.IMG_HDISP	(IMG_HDISP),
//	.IMG_VDISP	(IMG_VDISP)
//) u_VIP_Sobel_Edge_Detector (
//	.clk					(clk),
//	.rst_n					(rst_n),
//
//	//Image data prepred to be processd
//	.per_frame_vsync		(post2_frame_vsync),
//	.per_frame_href			(post2_frame_href),
//	.per_frame_clken		(post2_frame_clken),
//	.per_img_Y				({8{post2_img_Bit}}),
//
//	//Image data has been processd
//	.post_frame_vsync		(post4_frame_vsync),
//	.post_frame_href		(post4_frame_href),
//	.post_frame_clken		(post4_frame_clken),
//	.post_img_Bit			(post4_img_Bit),
//
//	//User interface
//	.Sobel_Threshold		(128)
//);
//
////--------------------------------------
////VIP算法--膨胀
//
//wire			post5_frame_vsync;
//wire			post5_frame_href;
//wire			post5_frame_clken;
//wire			post5_img_Bit;
//
//VIP_Bit_Dilation_Detector
//#(
//	.IMG_HDISP	(IMG_HDISP),	//640*480
//	.IMG_VDISP	(IMG_VDISP)
//)
//u_VIP_Bit_Dilation_Detector
//(
//	//global clock
//	.clk					(clk),
//	.rst_n					(rst_n),
//
//	//Image data prepred to be processd
//	.per_frame_vsync		(post4_frame_vsync),
//	.per_frame_href		    (post4_frame_href),
//	.per_frame_clken		(post4_frame_clken),
//	.per_img_Bit			(post4_img_Bit),
//
//	//Image data has been processd
//	.post_frame_vsync		(post5_frame_vsync),
//	.post_frame_href		(post5_frame_href),
//	.post_frame_clken		(post5_frame_clken),
//	.post_img_Bit			(post5_img_Bit)
//);
//

//-------------------------------------

wire 		PIC1_vip_out_frame_vsync;
wire 		PIC1_vip_out_frame_href ;
wire 		PIC1_vip_out_frame_clken;
wire [7:0]	PIC1_vip_out_img_R     ;
wire [7:0]	PIC1_vip_out_img_G     ;
wire [7:0]	PIC1_vip_out_img_B     ;

//第一张输出膨胀之后的结果
 assign PIC1_vip_out_frame_vsync 	= vsync_out	;
 assign PIC1_vip_out_frame_href  	= href_out 	;
 assign PIC1_vip_out_frame_clken 	= de_out	;
 assign PIC1_vip_out_img_R 			= {8{bin_out}};
 assign PIC1_vip_out_img_G 			= {8{bin_out}};
 assign PIC1_vip_out_img_B 			= {8{bin_out}};
//assign PIC1_vip_out_img_R 			= rgb_out[23:16];
//assign PIC1_vip_out_img_G 			= rgb_out[15:8] ;
//assign PIC1_vip_out_img_B 			= rgb_out[7:0]  ;



//寄存图像处理之后的像素数据

//-------------------------------------
//第一张图
reg [31:0]  PIC1_vip_cnt;
reg         PIC1_vip_vsync_r;    //寄存VIP输出的场同步
reg         PIC1_vip_out_en;     //寄存VIP处理图像的使能信号，仅维持一帧的时间

always@(posedge clk or negedge rst_n)begin
   if(!rst_n)
        PIC1_vip_vsync_r   <=  1'b0;
   else
        PIC1_vip_vsync_r   <=  PIC1_vip_out_frame_vsync;
end

always@(posedge clk or negedge rst_n)begin
   if(!rst_n)
        PIC1_vip_out_en    <=  1'b1;
   else if(PIC1_vip_vsync_r & (!PIC1_vip_out_frame_vsync))  //第一帧结束之后，使能拉低
        PIC1_vip_out_en    <=  1'b0;
end

always@(posedge clk or negedge rst_n)begin
   if(!rst_n) begin
        PIC1_vip_cnt <=  32'd0;
   end
   else if(PIC1_vip_out_en) begin
        if(PIC1_vip_out_frame_href & PIC1_vip_out_frame_clken) begin
            PIC1_vip_cnt <=  PIC1_vip_cnt + 3;
            vip_pixel_data_1[PIC1_vip_cnt+0] <= PIC1_vip_out_img_R;
            vip_pixel_data_1[PIC1_vip_cnt+1] <= PIC1_vip_out_img_G;
            vip_pixel_data_1[PIC1_vip_cnt+2] <= PIC1_vip_out_img_B;
        end
   end
end


endmodule
