WangBaren02/Image-acquisition-and-recognition-robotic-arm-analysis-and-control-system-based-on-FPGA/(commit log)

2025-10-30 Introduction to "技术文档"
    In the "技术文档," we have detailed the technical aspects involved in the entire system, summarized the processes of all modules, and provided an in-depth analysis of each module.
2025-10-30 Introduction to the "答辩PPT"
    The "答辩PPT" is used during the formal competition and summarizes the entire system's architecture and workflow. You can quickly understand the general content of the entire system by browsing this file.
2025-10-30 Introduction to "CICC_2025_Arm"
    The file "CICC_2025_Arm" contains the project files running on the AWC_C4 board (provided by Haiyun Jiexun). Its main function is to receive image information from another board, analyze it, and generate control signals for the robotic arm.
2025-10-30 Introduction to "new"
    The "new" file contains the project files running on the Wildfire Rising mini board. Its main function is to drive the OV5640 camera to acquire images, perform a series of pipelined digital image processing steps on them, and finally obtain the image information and transmit it to another board.
2026-09-09 codex维护
2026-09-09 介绍中文化
2026-09-09 代码更正
2026-09-10 流程图修改
2026-09-16 嘉立创工程
    [25集创赛海云捷讯杯.epro]
